redc6t/Agile/README.md

**Agile - Predictive Lap Timer with micro-sector analysis**

GPS lap timer and driver display for circuit racing. Agile times laps and micro-sectors, records the track outline and the pit lane, fuel bay and pit exit geofences, and shows pit board messages and race-control flags sent from the pit wall on the driver's dash.

Part of the Mullaloo Motorsport Engineering in-car system, alongside [BTTM](https://github.com/redc6t/BTTM) (Brake & Tyre Temperature Monitor) and [CIRTS](https://github.com/redc6t/CIRTS) (CAN Infrared Temperature Sensor). Consumed by [PWSM](https://github.com/redc6t/PWSM_Pit_Wall_Stategy_Manager) (Pit Wall Strategy Manager).

| | |
|---|---|
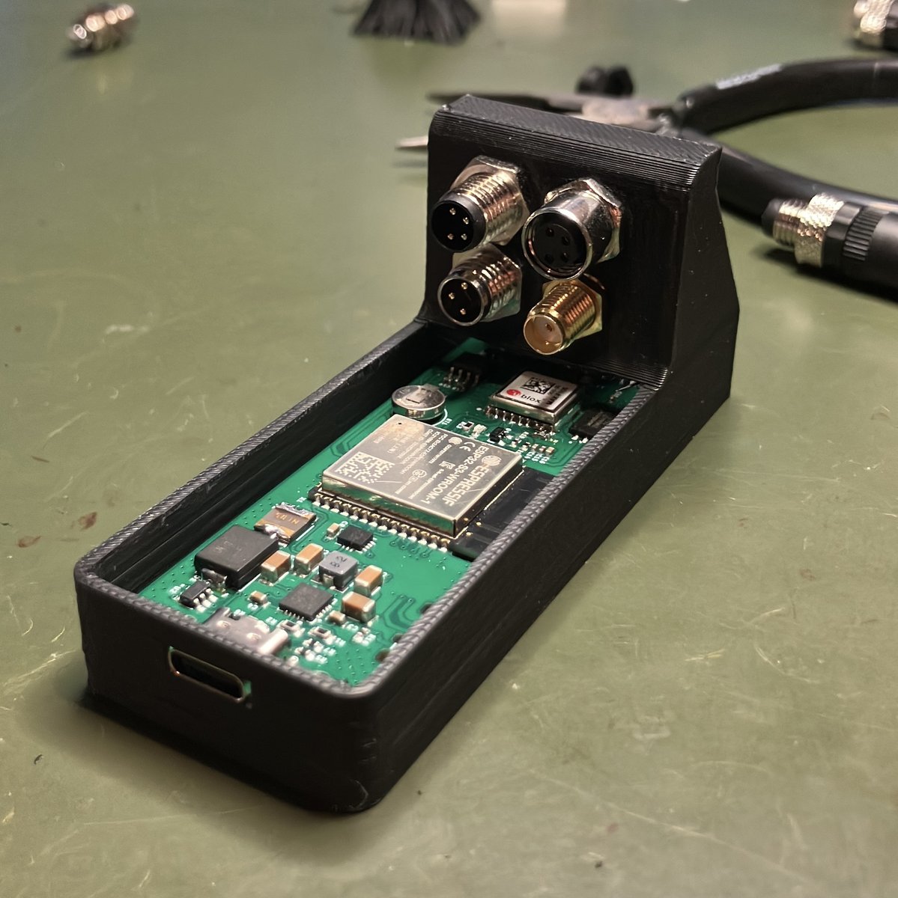
[picture p1: Documentation/Photos/agile_v1.0_open_mainboard.jpg]
Inside the v1.0 enclosure: main board with ESP32-S3 and GNSS behind the connector panel
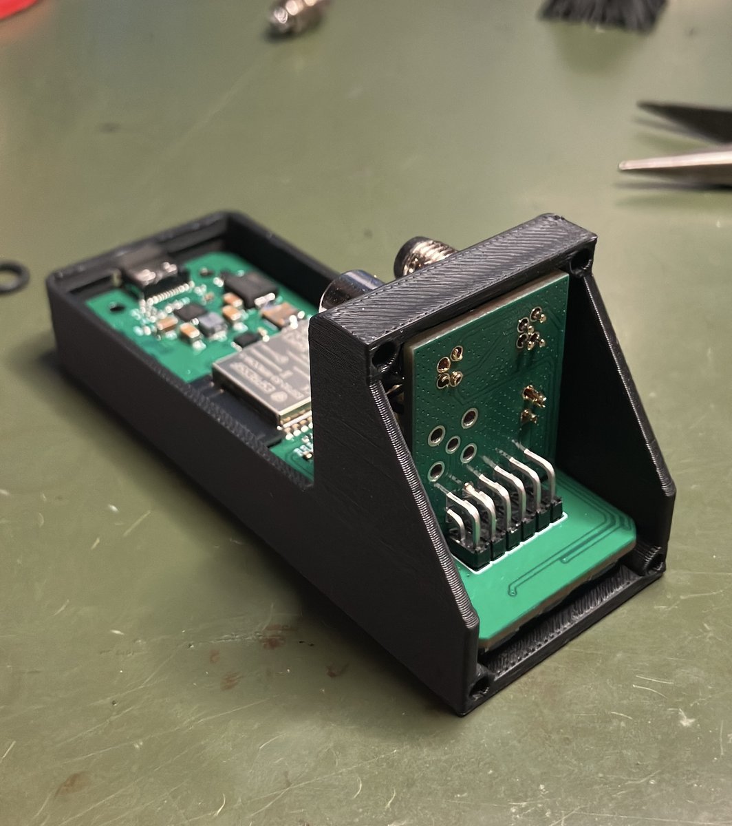
[picture p2: Documentation/Photos/agile_v1.0_open_display.jpg]
Display board in its angled mount inside the open v1.0 enclosure
|  |  |
| Inside v1.0: the main board with the ESP32-S3 and u-blox GNSS behind the connector panel. | The display board in its angled mount, from inside the open v1.0 enclosure. |

Racing dash: gaining 0.8 s

**Features**

- GNSS lap trigger on a start/finish **line** laid across track and pit lane, crossing time interpolated to the millisecond
- Recon lap that builds micro-sectors automatically (up to 32, about one per 150 m)
- Live time delta against the best clean lap, with an auto-ranging delta bar (0.5 to 30 s)
- Geofences for pit entry, pits, fuel bay and pit exit; pit-aware timing (pitted laps never become the reference)
- Pit board messages and latched race-control flags (yellow, safety car, red) the driver cannot dismiss
- IMU (LSM6DSV16X) for sector detection, levelling and GPS-assisted yaw learning
- Append-only NAND session logs, downloadable over Wi-Fi or mounted as a USB drive
- Wi-Fi web app (live view, circuit editor, diagnostics, OTA) plus WebSocket/HTTP API for pit wall clients

**System overview**

```mermaid
flowchart LR
    subgraph Car
        GNSS[MAX-F10S GNSS<br/>10 Hz] --> Agile
        IMU[LSM6DSV16X IMU<br/>240 Hz] --> Agile
        BTN[OK / UP / DOWN] --> Agile
        Agile[ESP32-S3<br/>Agile firmware] --> TFT[284×76 TFT<br/>driver display]
        Agile --> NAND[(512 MB NAND<br/>session logs)]
    end
    Agile <-->|Wi-Fi: HTTP + WebSocket| AP((Trackside AP))
    AP <--> WEB[Browser web UI]
    AP <--> PWSM[PWSM pit wall]
    Agile -.->|USB export mode| PC[PC: LOG_nnnn.CSV]
```

**How a session runs**

```mermaid
stateDiagram-v2
    direction LR
    [*] --> IDLE: boot
    IDLE --> RECON: cross S/F, no stored map
    IDLE --> RACING: cross S/F with stored map accepted (OK)
    RECON --> RACING: cross S/F, sectors synthesised, approve 15 s
    RECON --> IDLE: stopped > 10 s (abort)
    RACING --> RACING: cross S/F, lap closed, faster clean lap becomes reference
    RACING --> IDLE: long OK press (new S/F) or learned-state reset
```

1. Load a circuit (S/F line plus pit zones) from the web Config tab with **Load to Device**. The idle screen shows the circuit name and `S/F:LINE`.
2. Drive across the line. The first lap is a **recon lap**: the unit records the track and finds braking, cornering and acceleration events.
3. At the line it synthesises the micro-sectors and shows `ROAD 9 SEC  OK=KEEP HOLD=REDO`. Lap 2 is timed against the recon lap.
4. Every faster lap that did not touch the pits becomes the new reference. Pit visits are shown full-screen and are left out of the timing.
5. Next time, parked within 500 m of the same S/F, the unit offers `MAP n SEC: OK=USE`, which skips the recon lap.

| Idle, waiting for the line | Recon approve | Latched yellow flag | Pit lane |
|---|---|---|---|
|  |  |  |  |

Every screen and scenario is in [Documentation/Display.md](Documentation/Display.md).

**Driver controls**

| Input | Action |
|---|---|
| OK short | Keep the new sector map / use the stored map / cancel a pending reset |
| OK hold 1.2 to 10 s | Set a point S/F at the current position and start over |
| OK hold 10 s or more | Level the IMU (car still, level ground) |
| UP hold 10 s, stopped | Erase learned state (map, best lap, traces) after a 5 s countdown |
| UP held at power-on | USB log export mode |
| DOWN held at power-on | Five diagnostic pages |
| DOWN held on the approve screen | Synthesis breakdown |

**Web interface**

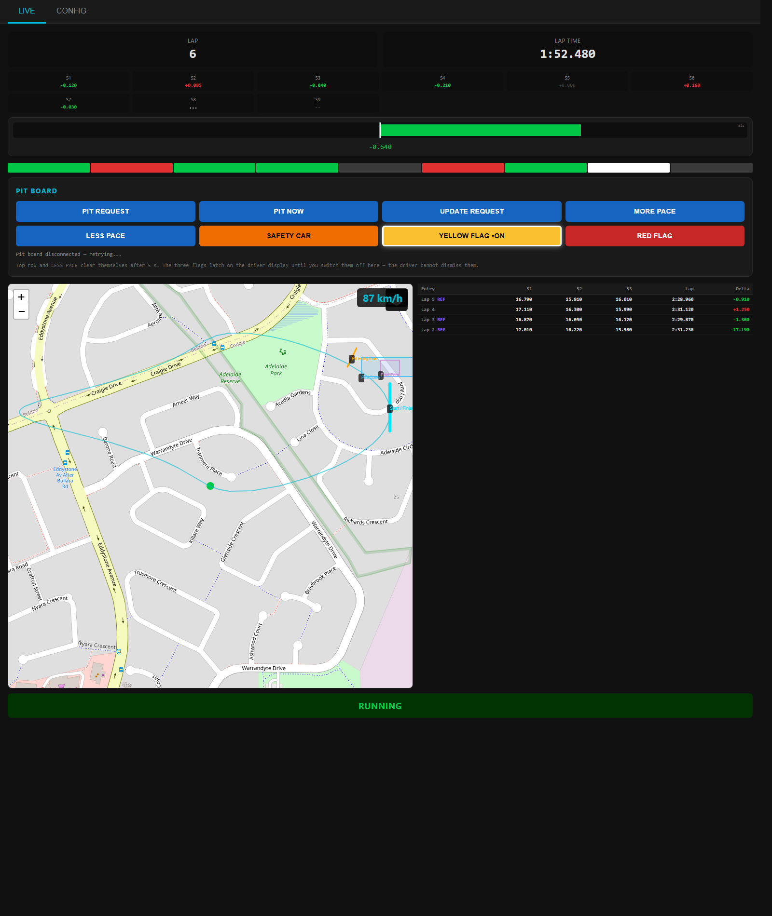
[picture p3: Documentation/WebUI/img/live_tab.png]
Web UI, Live tab


Live tab: lap, sectors, delta bar, pit board, map, lap history. Config tab: circuit and zone editor, Wi-Fi, diagnostics, thresholds, logs, IMU orientation, OTA. See [Documentation/WebUI.md](Documentation/WebUI.md) and the API in [Documentation/Interface.md](Documentation/Interface.md).

**Firmware architecture**

```mermaid
flowchart TB
    subgraph Core0[Core 0]
        G[gnssTask 50 Hz poll] -->|latest fix| L
        I[imuTask 200 Hz] -->|latest sample| L
        L[lapTask 100 Hz<br/>state machine, delta, sectors, geofence]
        L -->|CSV rows| W[logWriterTask] --> N[(NAND)]
        WF[wifiMonitorTask] --> WS[AsyncWebServer + /ws]
    end
    subgraph Core1[Core 1]
        D[displayTask 20 Hz<br/>owner stack + TFT]
    end
    L -->|snapshot, spinlock| D
    L -->|snapshot| WS
    D -->|live frame 10 Hz| WS
    WS -->|pit messages / flags| D
    WS -->|circuits, thresholds, reset| L
```

Full pseudocode of the firmware: [Documentation/Pseudocode.md](Documentation/Pseudocode.md). Architecture notes: [Documentation/Architecture.md](Documentation/Architecture.md).

**Hardware**

<p align="center">
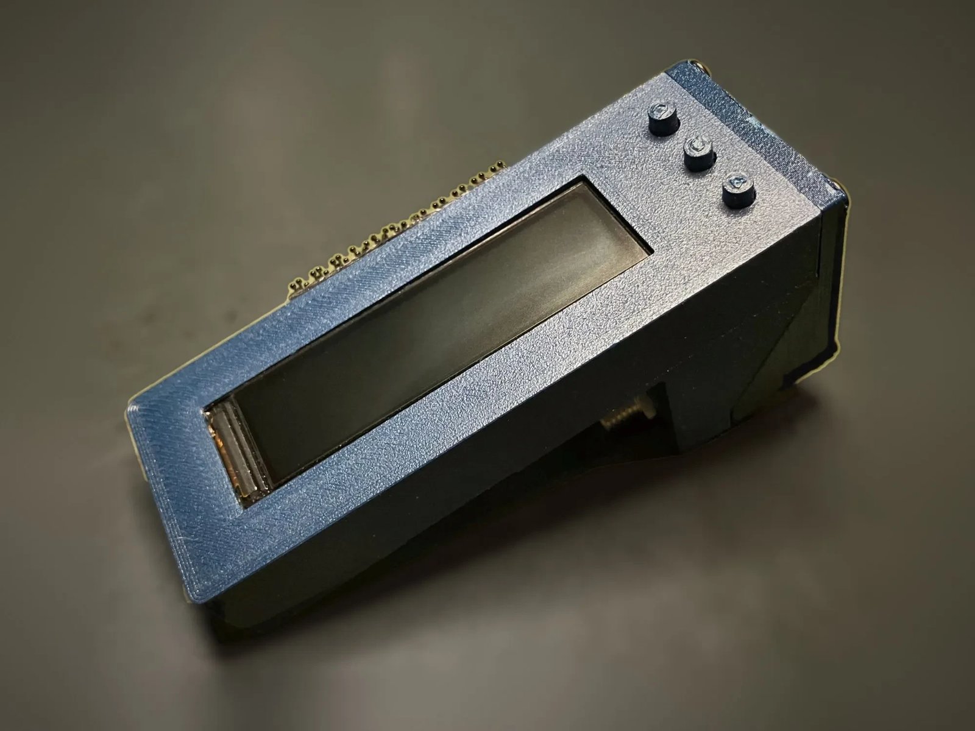
[picture p4: Documentation/Photos/agile_v1.0.jpg]
Agile v1.0: angled 3D-printed enclosure with the 284×76 TFT and OK / UP / DOWN buttons
  
</p>

| Component | Part | Interface |
|---|---|---|
| MCU | ESP32-S3-WROOM-1-N16R8 (16 MB flash, 8 MB OPI PSRAM) | - |
| GNSS | u-blox MAX-F10S (GPS L1, Galileo E1/E5a, BeiDou B1C/B2a) | UART1, 460800 baud |
| IMU | ST LSM6DSV16X | SPI (FSPI) |
| Storage | Winbond W25N04KV 4 Gbit SPI NAND | SPI (HSPI, shared with TFT) |
| Display | ST7789 TFT, 284×76 | SPI (HSPI) |
| CAN | TI TCAN3413 (fitted, disabled in firmware) | TWAI |
| Buttons | OK, UP, DOWN | GPIO 8 / 11 / 12 |

Parts as used by firmware v0.17.0. All PCB designs are custom. See [Hardware](Hardware/README.md).

**Repository layout**

```text
Agile/
├── README.md                 this file
├── Documentation/
│   ├── Architecture.md       block diagram, tasks, timing logic, storage
│   ├── Pseudocode.md         the whole firmware as pseudocode
│   ├── Display.md            every TFT screen and scenario (rendered)
│   ├── Display/
│   │   ├── render_tft.py     regenerates the screens from the firmware's drawing code
│   │   └── screens/*.svg     63 rendered screens
│   ├── WebUI.md              web app, tab by tab
│   ├── WebUI/
│   │   ├── mock_server.py    serves the real web UI against mock data
│   │   └── img/              screenshots
│   ├── Interface.md          WebSocket + HTTP API (PWSM)
│   ├── Flowchart/            state machine diagrams
│   └── Manuals/              driver / pit crew / installation manuals
├── Firmware/
│   ├── Agile/                Arduino sketch (Agile.ino)
│   ├── lib/                  local libraries
│   ├── tools/                partitions.csv, host helpers
│   ├── releases/             tagged binaries
│   └── CHANGELOG.md
├── Hardware/
│   ├── PCB/                  LibrePCB project, schematic and board PDFs, 3D STEP
│   ├── Fabrication/          Gerber, BOM, CPL per revision
│   ├── Enclosure/            Onshape exports
│   └── Datasheets/
└── Photos-Journal_Megadump/  build journal photos
```

| Path | Contents |
|---|---|
| [Firmware/](Firmware/README.md) | Arduino sketch, local libraries, tools, release binaries, firmware changelog |
| [Hardware/](Hardware/README.md) | LibrePCB project, fabrication outputs (Gerber/BOM/CPL), enclosure CAD, datasheets, PCB changelog |
| [Documentation/](Documentation/README.md) | Architecture, pseudocode, display, web UI, pit wall interface, manuals, flowcharts |
| Photos-Journal_Megadump/ | Build journal photos, one folder per milestone |

**Applications**

Designed for circuit racing, track days and motorsport testing, giving entry-level drivers and club teams timing and pit wall communication usually reserved for well-funded teams.

**License**

| Part | Licence |
|---|---|
| Hardware (schematics, PCB, fabrication files, enclosure) | [CERN-OHL-S-2.0](https://ohwr.org/cern_ohl_s_v2.txt) |
| Documentation (including the firmware pseudocode and diagrams) | [CC BY 4.0](https://creativecommons.org/licenses/by/4.0/) |
| Firmware (source and binaries) | Proprietary, all rights reserved. The source is not published; binaries are free to use on Agile hardware. See [Firmware/LICENSE](Firmware/LICENSE). |

See [LICENSE](LICENSE) for details.

By: Pietro Gambarin (pietro.gambarin@gmail.com)
