redc6t/Agile/Hardware/PCB/3D/PLTD_v1.1.step

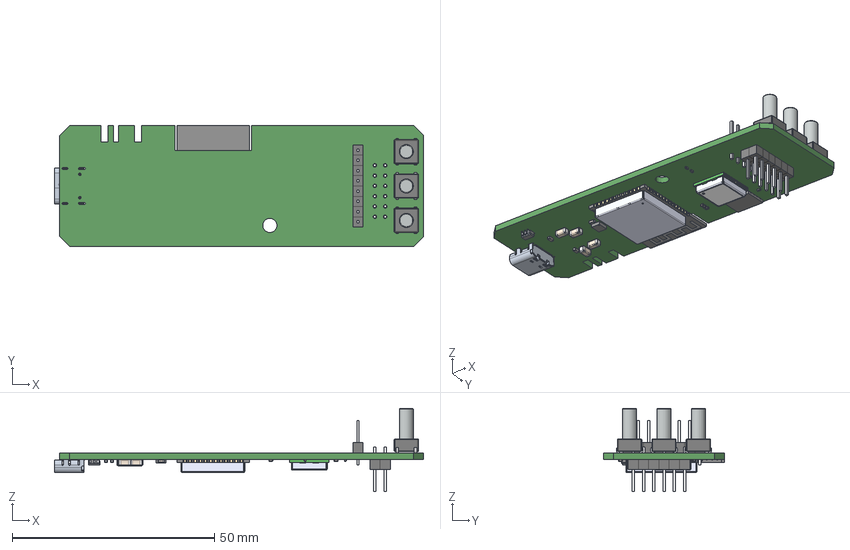
[picture p6: CAD file, 2026-10-16]
Hardware/PCB/3D/PLTD_v1.1.step
91.2 x 30.0 x 20.6 mm
PCB:1
C1:1
C2:1
C3:1
C4:1
C5:1
C6:1
C8:1
C10:1
C14:1
C15:1
C16:1
C17:1
C18:1
C19:1
DOWN:1
INTERFACE_IN:1
J2:1
J4:1
RESET-OK:1
U2:1
U3:1
U5:1
U6:1
UP:1
X1:1
