redc6t/Agile/Hardware/pcb_changelog.txt

Agile - Predictive Lap Timer with micro-sector analysis

v0.1 (Work in progress)
- Initial board
