redc6t/Agile/Photos-Journal_Megadump/1) 0.17 photoshoot/IMG_3626.jpeg

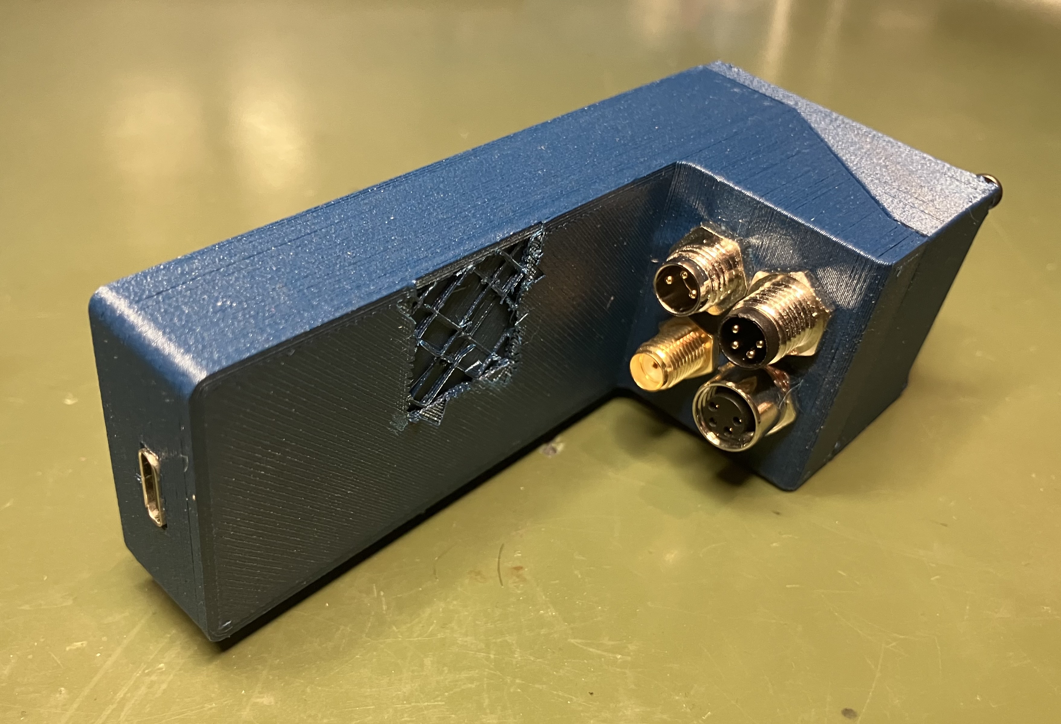
Photos-Journal_Megadump/1) 0.17 photoshoot/IMG_3626.jpeg
