redc6t/Agile/Hardware/PCB/Schematic/PLTD_v1.1_Schematics.pdf

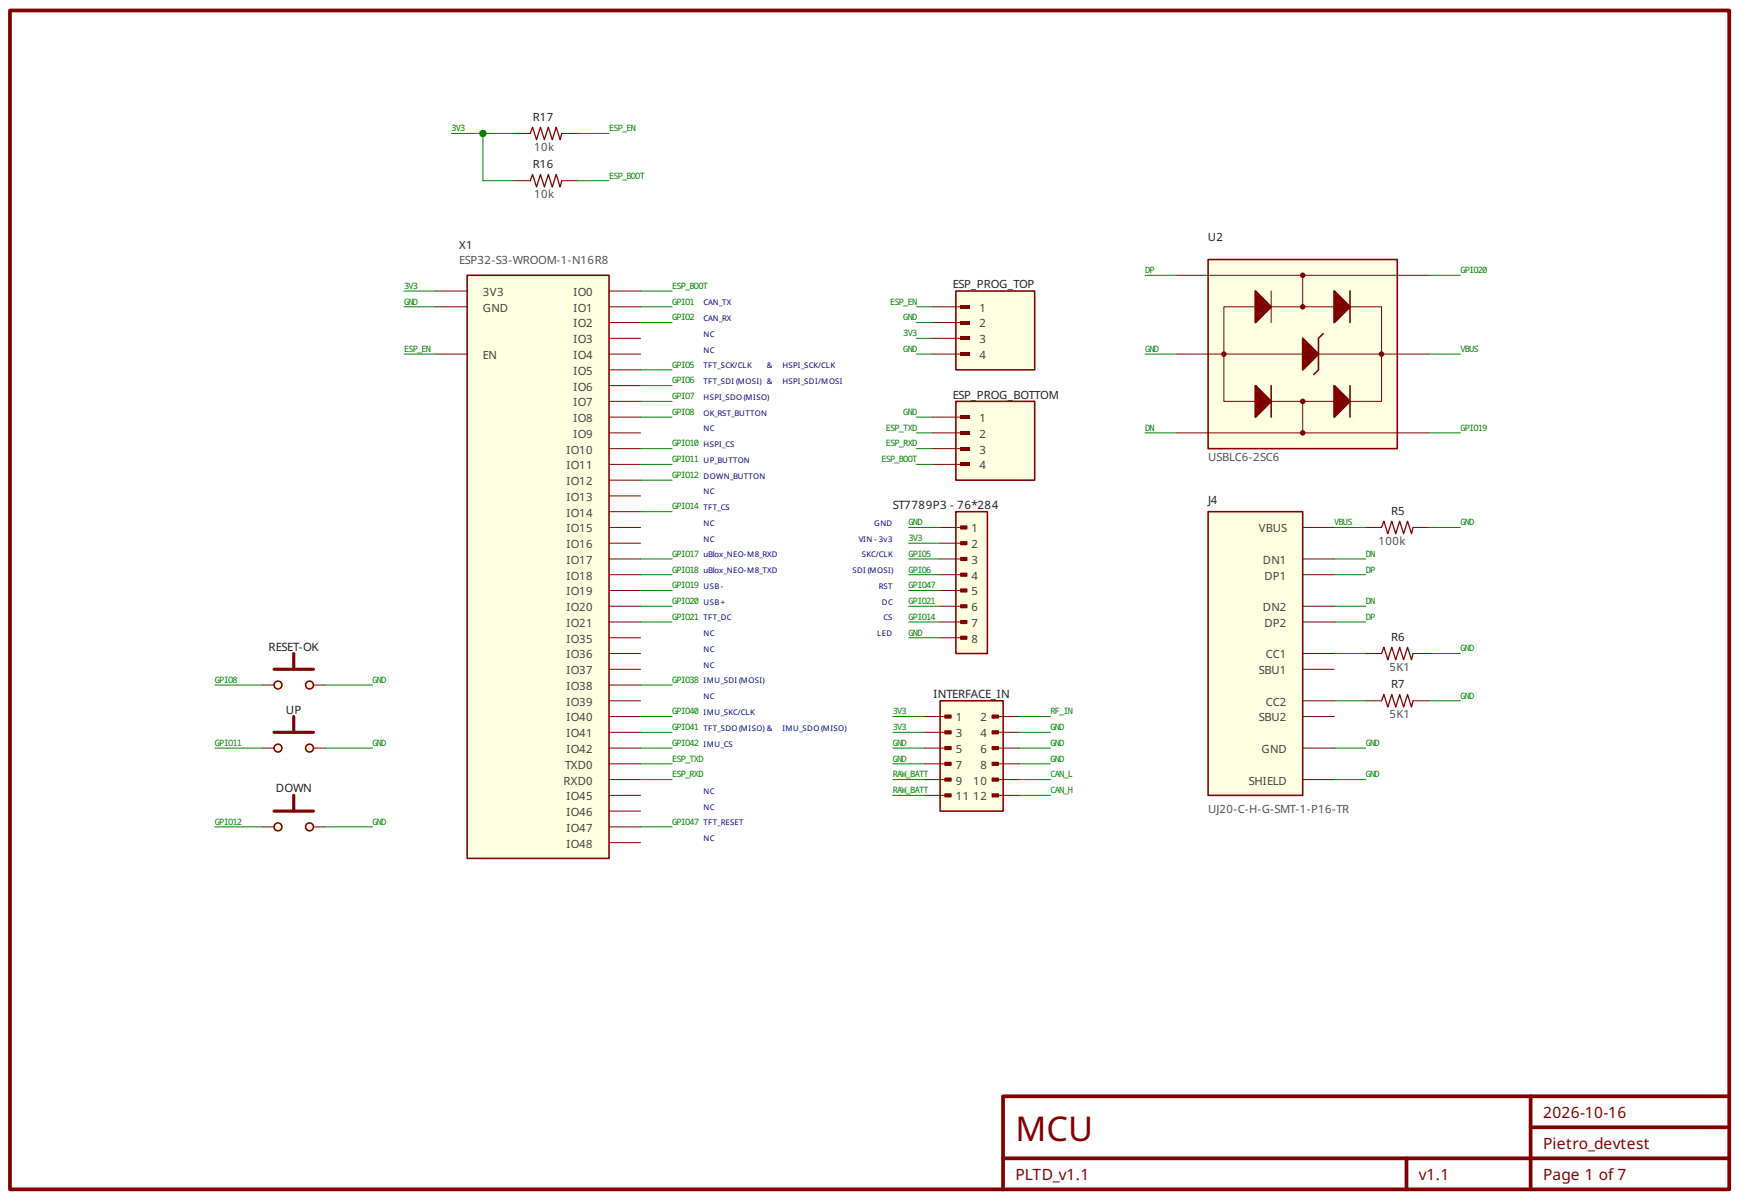
[picture p12: page 1]
IMU_SDO (MISO); SDI (MOSI); VIN - 3v3; TFT_SDI (MOSI); IMU_SDI (MOSI); TFT_SDO (MISO); HSPI_SDO (MISO)

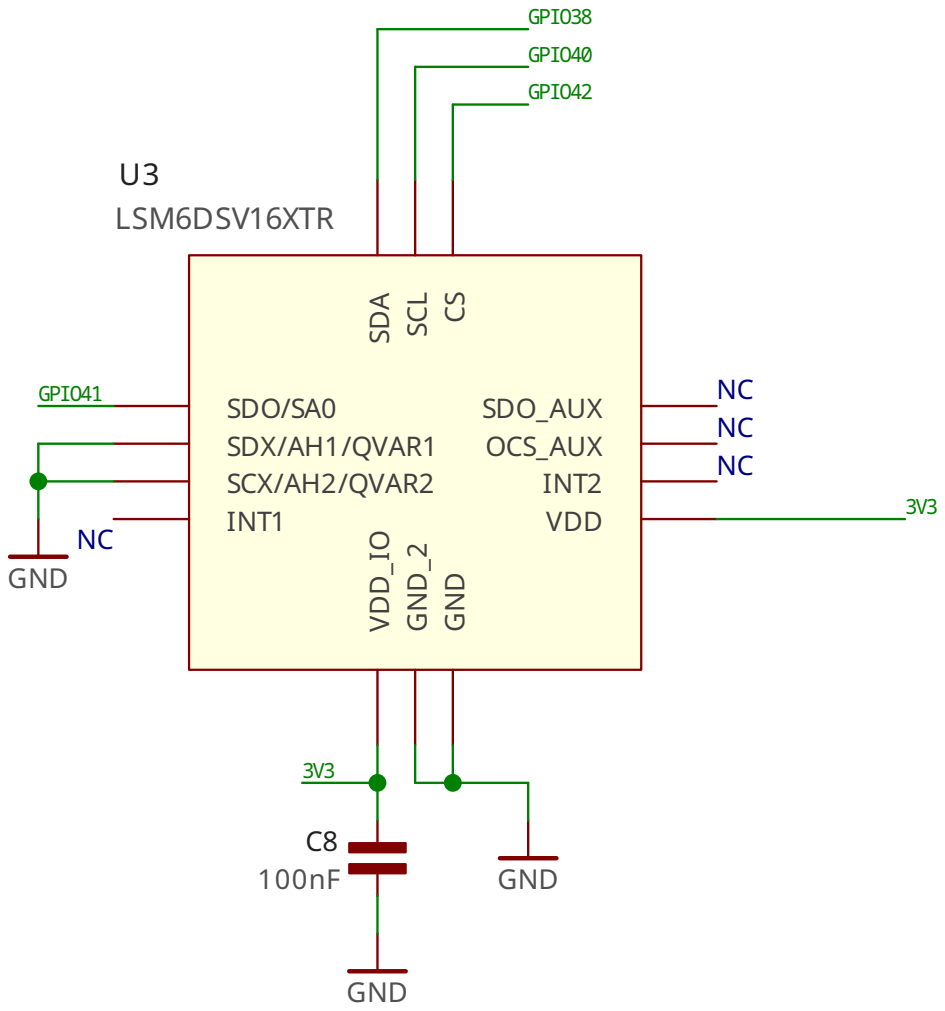
[picture p13: page 2]
Pietro_devtest IMU

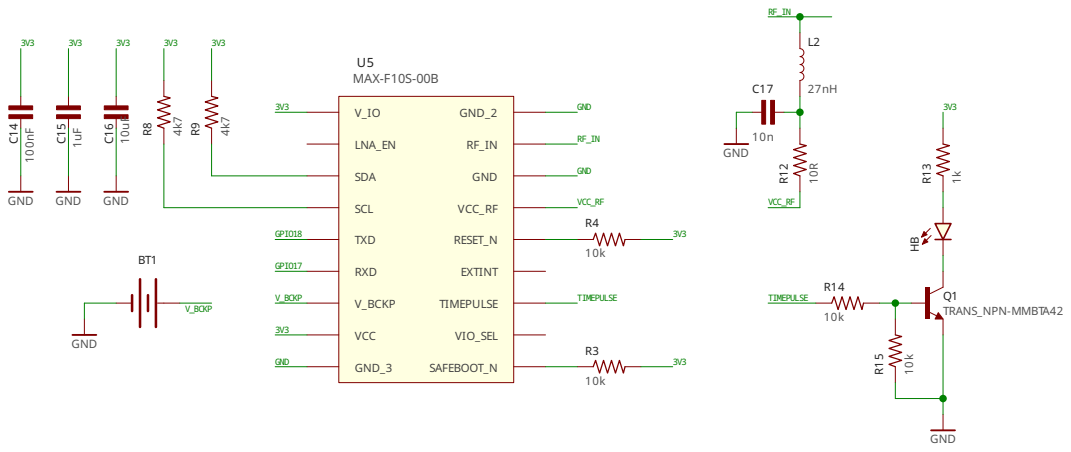
[picture p14: page 3]

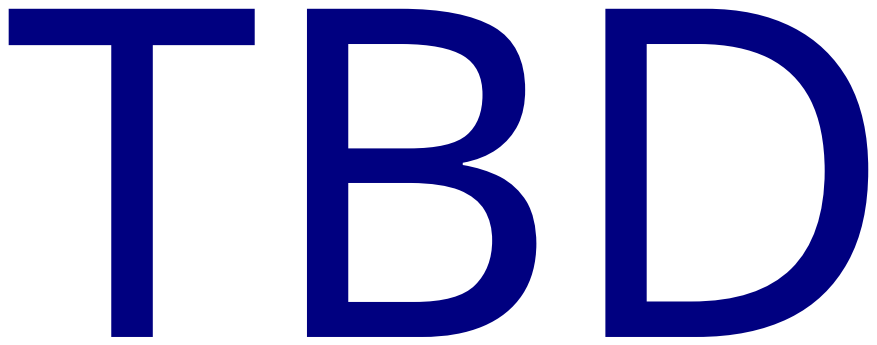
[picture p15: page 4]

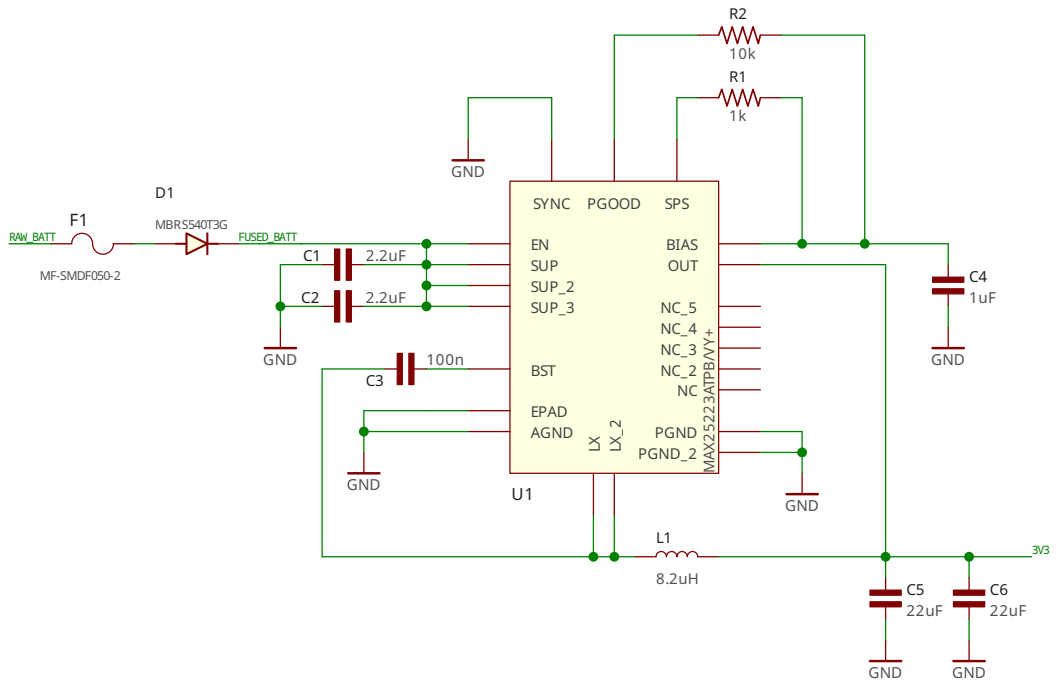
[picture p16: page 5]

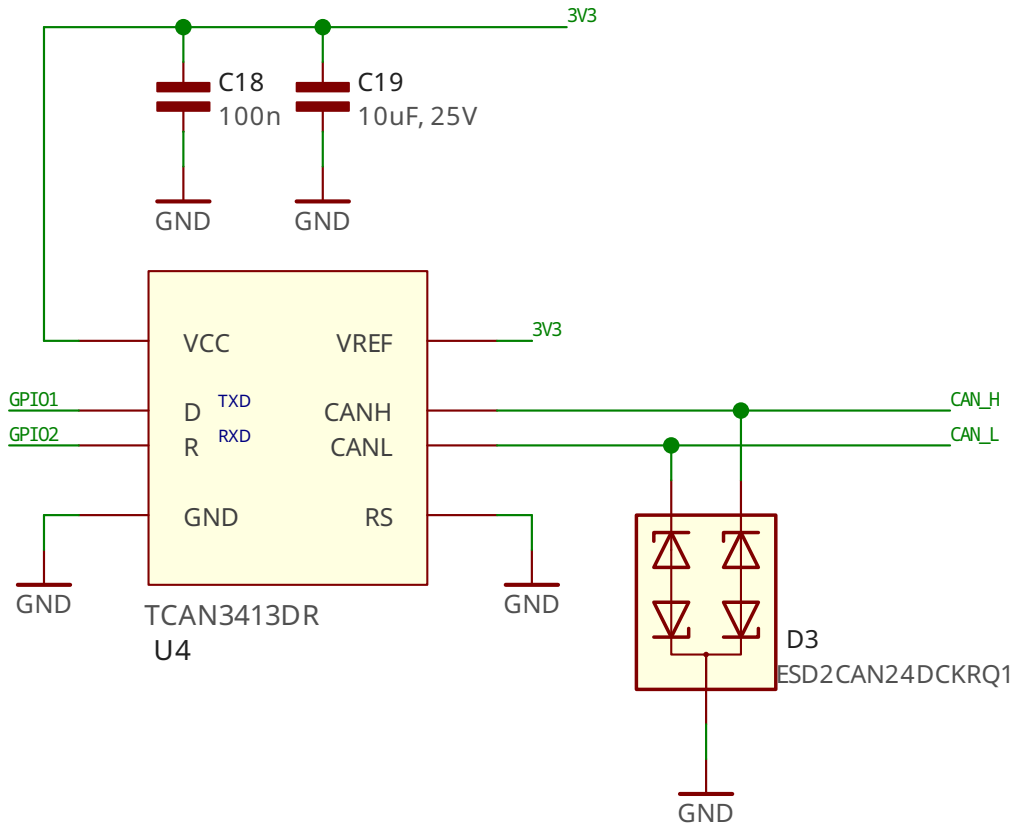
[picture p17: page 6]

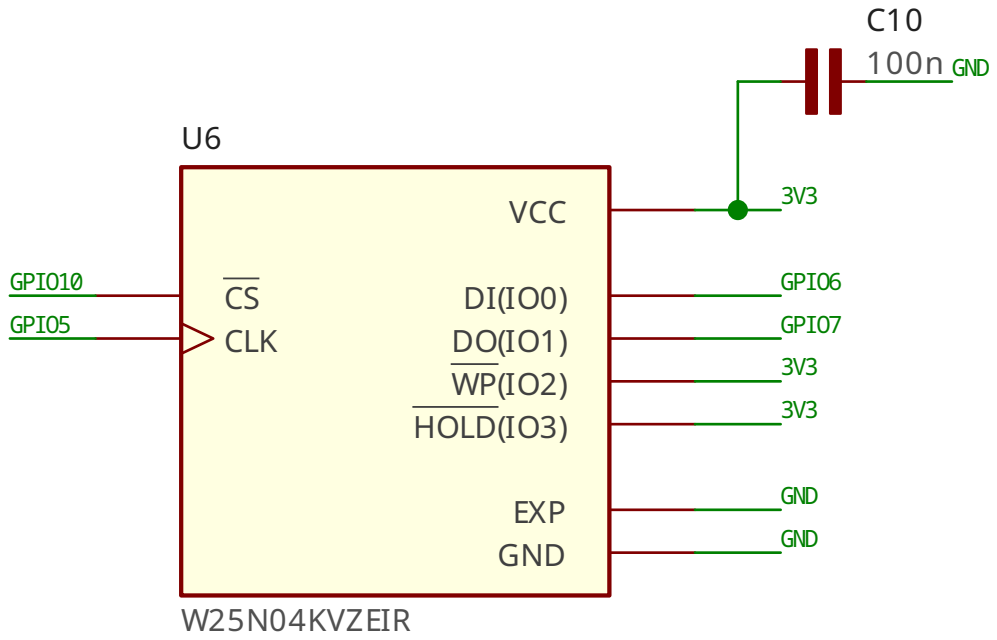
[picture p18: page 7]
Memo; Pietro_devtest ry
