redc6t/Agile/Hardware/PCB/Board/PLTD_v1.1_Board.pdf

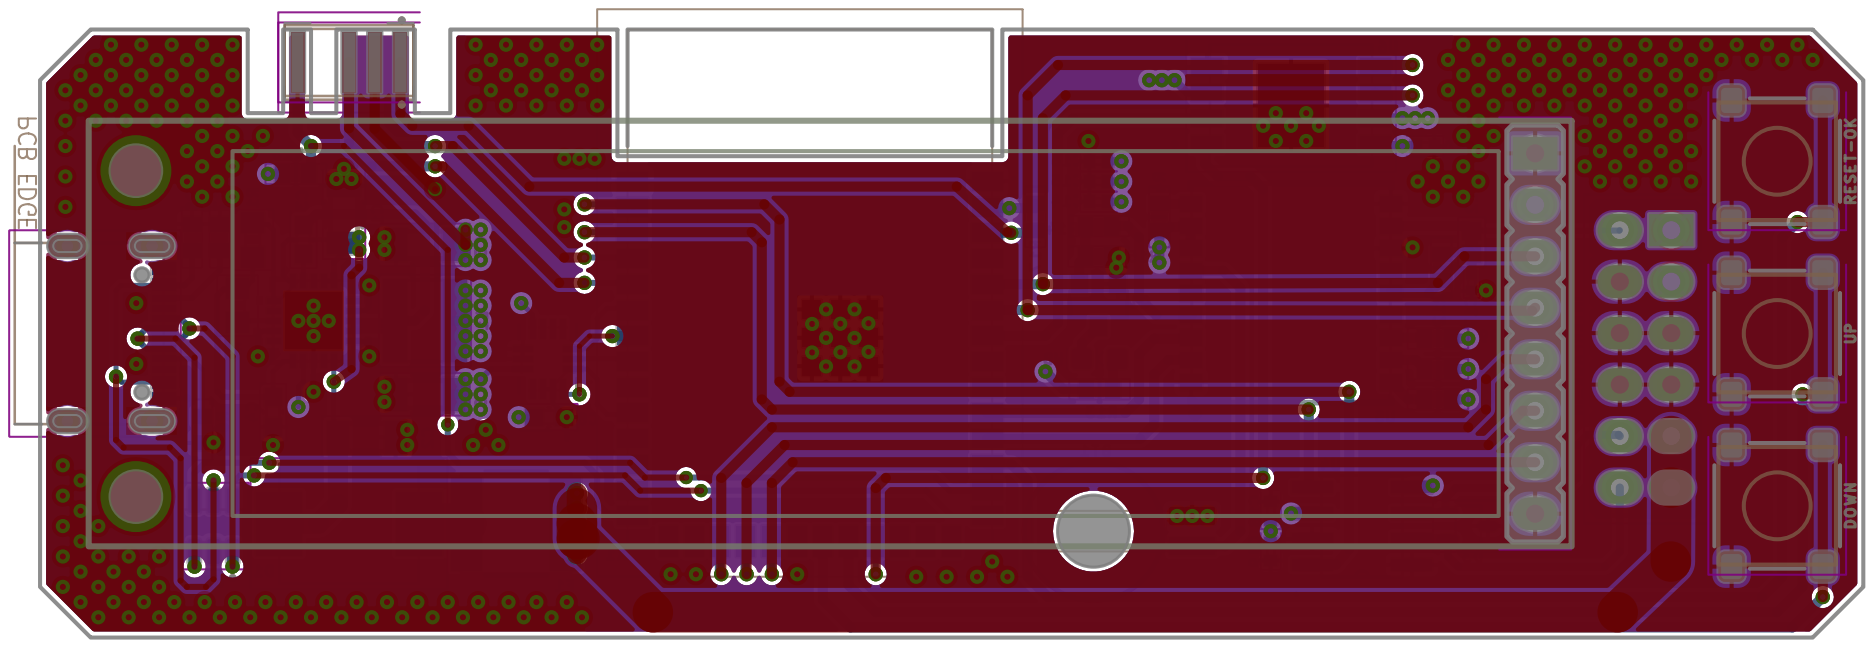
[picture p19: page 1]

UP DOWN RESET-OK

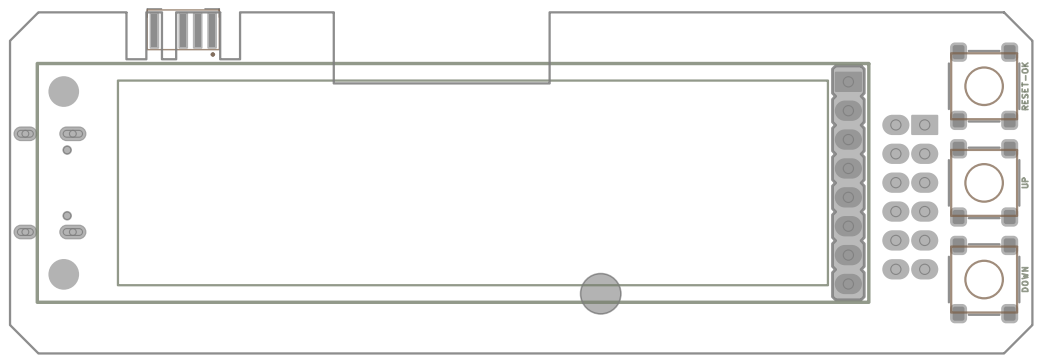
[picture p20: page 2]

UP DOWN RESET-OK

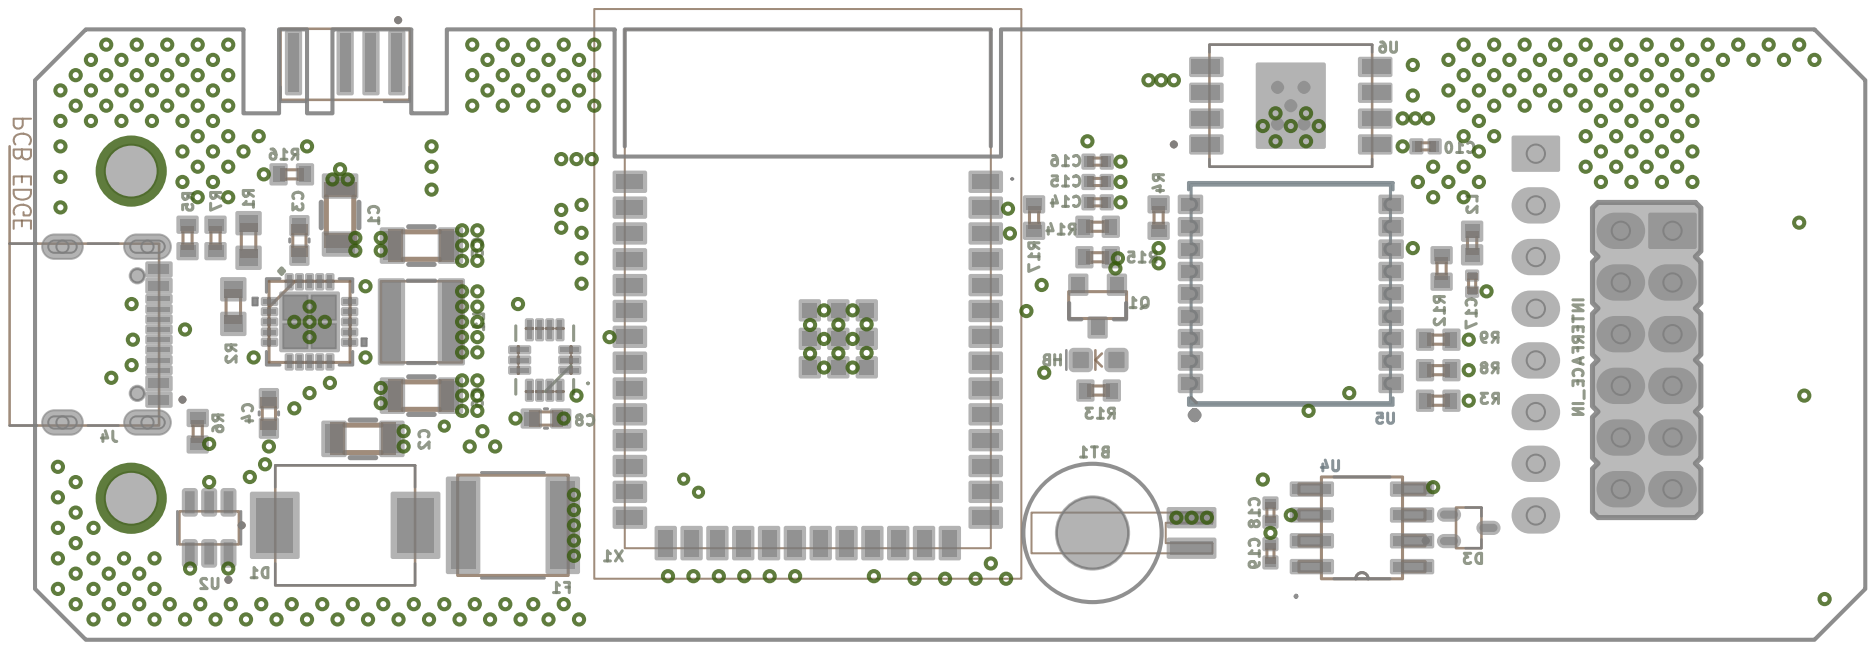
[picture p21: page 3]

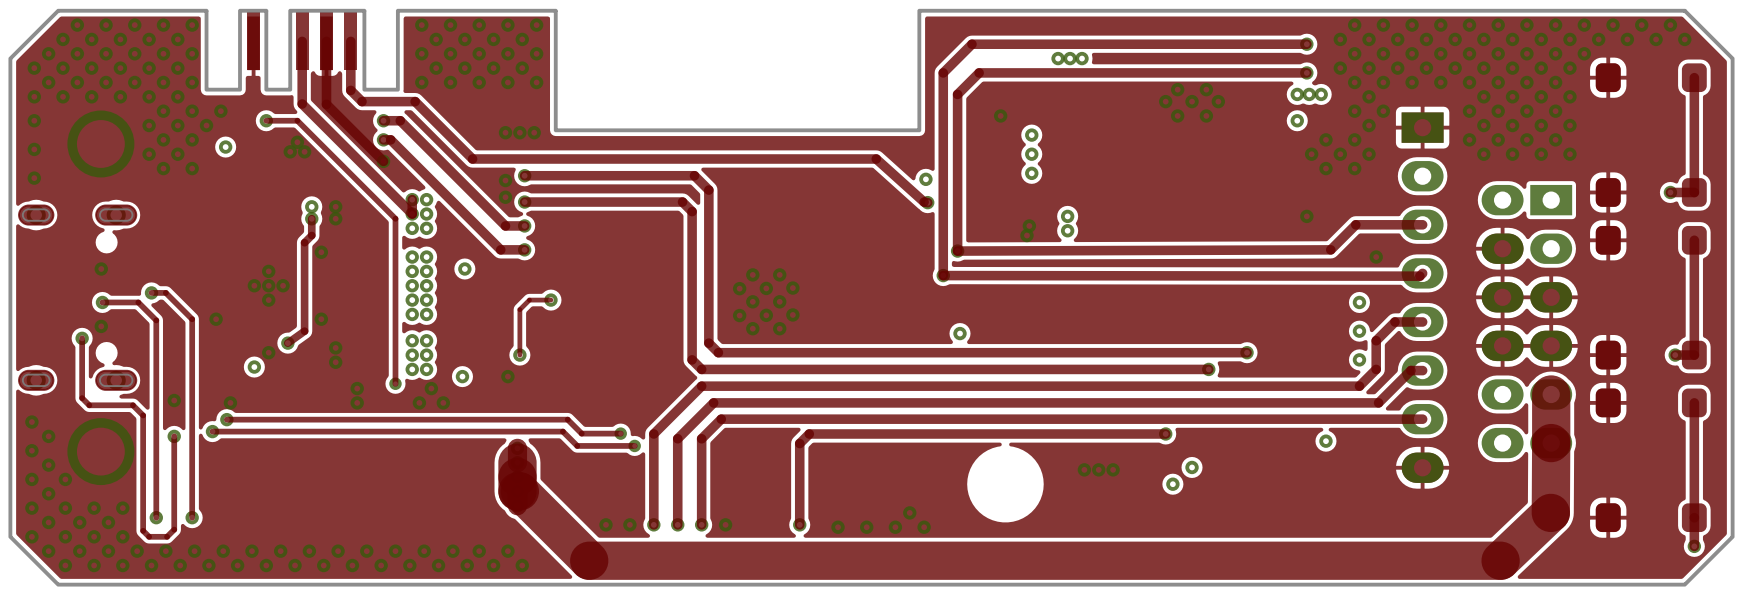
[picture p22: page 4]

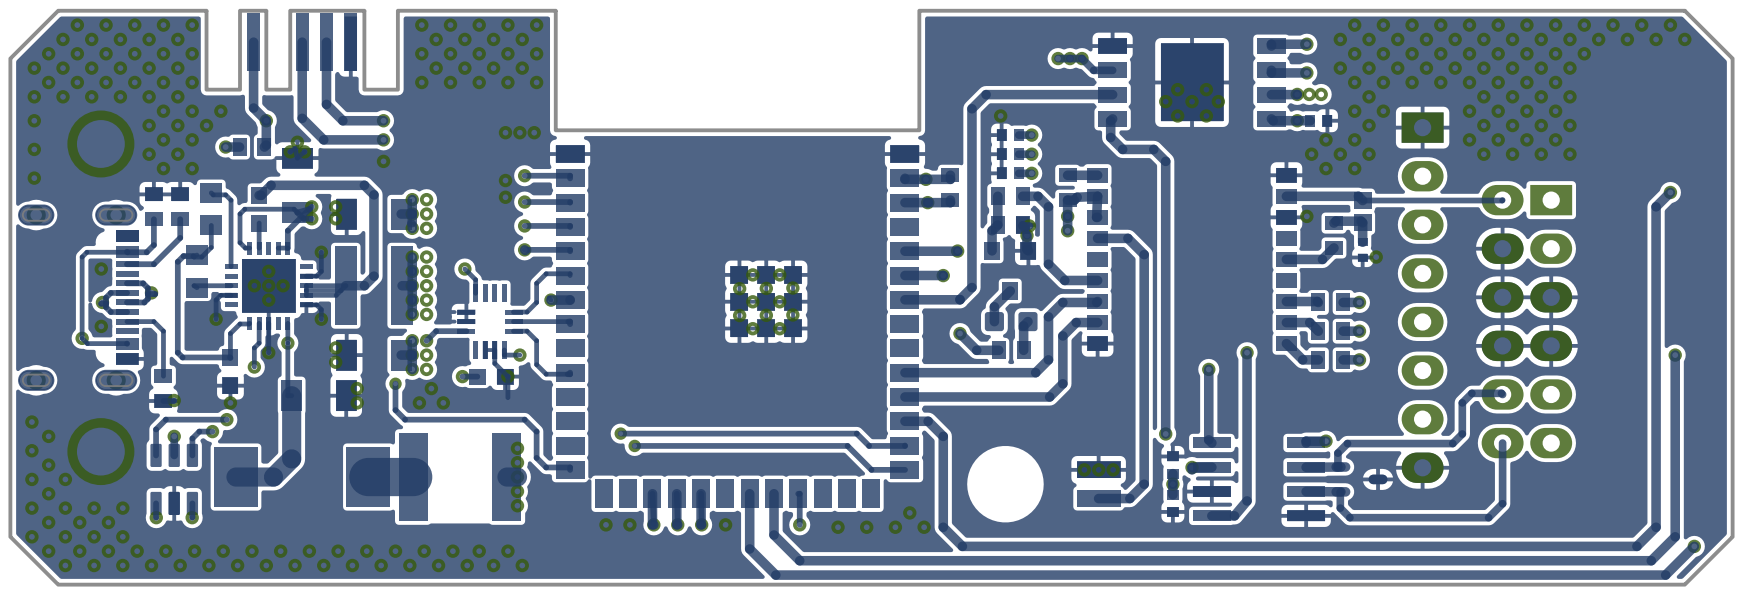
[picture p23: page 5]
