redc6t/Agile/(commit log)

2026-10-16 Replace MIT with split licensing: open hardware and docs, proprietary firmware
    - LICENSE: replace the MIT text with a per-part notice. Hardware is
    CERN-OHL-S-2.0, documentation (including the pseudocode) is CC BY 4.0,
    and firmware is proprietary.
    - Firmware/LICENSE (new): all rights reserved. Binaries may be used on
    PLTD hardware only; no modification, redistribution or reuse in other
    products. Third-party library licences keep their own rights. No
    warranty, not a safety device, and the licence terminates on breach.
    - README.md: licence section rewritten as a per-part table; drops the
    old MIT/GPL lines.
    - Hardware/README.md: hardware licence changed from CC BY-SA 3.0 to
    CERN-OH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
2026-10-16 Add hardware technical specification for PCB v1.1 / firmware v0.17.0
    New Documentation/TechnicalSpec.md compiled from the v1.1 schematic,
    board prints and STEP model, plus the v0.17.0 firmware docs.
    - Board outline, power path and rails, MCU/flash/PSRAM, partition table
    - Full GPIO map with firmware usage
    - GNSS, IMU, NAND, TFT, USB-C, CAN, buttons, HB LED sections
    - INTERFACE_IN pinout, programming headers, task/bus resource map
    - BOM from schematic
    - Known discrepancies and open items (stale labels, no USB power,
    no EN cap, no CAN termination, uncharacterised power figures)
    Linked from Documentation/README.md.
2026-10-17 Rename product from PLTD to Agile in docs and licences
    Replace PLTD with Agile across README, LICENSE, firmware licence,
    changelogs, hardware naming convention and all documentation.
    Move the sketch folder Firmware/PLTD/ to Firmware/Agile/ and update
    .gitignore. Add a former-name clause to the firmware licence so
    already-shipped PLTD units stay covered.
    Firmware identifiers that v0.17.0 still uses (USB "PLTD LOG STORE",
    NVS "pltd-wifi") and released file names (PLTD_v1.1 PDFs/STEP,
    PLTD_v0.17.0.ino.bin) are left as-is until the next firmware and
    board export.
2026-10-17 Rename product from PLTD to Agile in docs and licences
    New name and tagline: "Agile - Predictive Lap Timer with micro-sector
    analysis" (README, LICENSE, PCB changelog). Replace PLTD with Agile
    across the firmware licence, changelogs, hardware naming convention
    and all documentation. Move the sketch folder Firmware/PLTD/ to
    Firmware/Agile/ and update .gitignore. Add a former-name clause to
    the firmware licence so already-shipped PLTD units stay covered.
    NVS "pltd-wifi", which stays) and released file names (PLTD_v1.1
    PDFs/STEP, PLTD_v0.17.0.ino.bin) are left as-is until the next
    firmware and board export.
    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
2026-10-22 Document TFT backlight dimming mod and v0.18.0 brightness API
    Firmware v0.18.0 (source kept local in Sauce/) adds TFT backlight
    brightness control from the web Config tab: 10-100 % slider with live
    preview, Day/Dusk/Night presets, NVS-saved level applied before the TFT
    starts.
    Hardware: v1.1 rework switches the TFT LED pin low-side with an
    MGSF1N03LT1G, gate on GPIO48 via 100R with a 10k pull-up to 3V3
    (backlight fails full-on; the pull-up also lets firmware detect the mod).
    - TechnicalSpec: GPIO48 row, new section 7.4.1 with wiring, detection
    and bench check, open item 8 updated
    - Interface: GET/POST /brightness
    - WebUI: Display Brightness card
    - CHANGELOG: v0.18.0 entry (provisional, n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
2026-10-25 Add enclosure photos to README
    Add a hero shot of the v1.0 unit under the intro and two open-enclosure
    photos (main board, display board) at the top of the Hardware section.
    Web-sized copies (≤1600 px, ~150-180 KB each) live in
    Documentation/Photos/ so the README doesn't pull the full-resolution
    originals from Photos-Journal_Megadump/.
2026-10-25 Add enclosure photos to README
    Add two open-enclosure photos (main board, display board) side by side
    under the intro, and a shot of the finished v1.0 unit at the top of the
    Hardware section.
    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
2026-11-05 v0.20.0: fuel zone from any state, sector pass timing, Config panels
    - CHANGELOG: v0.20.0 entry (fuel zone triggers from any car state, sector
    boundaries complete at closest approach instead of a 30 m circle, boot
    log rows flushed again, SEC log row per boundary, Config tab grid layout)
    - Pseudocode: fuel zone resolved after the zone loop, from any state;
    state diagram gains RUNNING -> FUELLING and FUELLING -> RUNNING
    - WebUI: Fuel Zone row and a note on the new Device Settings panel grid
2026-11-05 v0.20.1: finish sector timed at S/F, geo_label cleared
    v0.20.1 entry (finish sector from the last IMU boundary to
    S/F, closed by the S/F crossing, appended to older stored maps;
    geo_label empty outside custom zones; v0.20.0 confirmed on track in
    LOG_0002)
    - Pseudocode: sector completion now describes the closest-approach pass
    (v0.20.0) and the finish sector closed at the lap crossing; synthesis
    step 5b appends the finish sector; diagram updated
2026-11-10 Document v0.21.0 engineer view: recon feed, remote OK, sector map
    Firmware v0.21.0 (source local-only) adds web-side visibility for running
    the car from the pits; recon, synthesis, timing and geofence logic are
    unchanged.
    - CHANGELOG: v0.21.0 entry (driver display mirror, recon card with
    Keep / Use stored map / Discard, live event log, read-only sector map,
    EVT log rows, /recon /events /approve).
    - Interface.md: GET /recon, GET /events, POST /approve.
    - WebUI.md: v0.21.0 engineer view section.
    - mock_server.py: replays a recon lap (IDLE, 40 s recon, approve window),
    serves /recon and /events, handles POST /approve and /nuke.
2026-11-12 v0.21.1: pits zone triggers from RUNNING, entry line optional
    The pits polygon only switched the car to PITS from PIT ENTRY, so the
    pit entry line had to fire first. A circuit without an entry line, or a
    car that booted in the garage, stayed RUNNING inside the pits.
    - Inside any pits polygon from RUNNING or PIT ENTRY is PITS (not from
    PIT EXIT; an exit line crossed on the same fix and the fuel zone
    still win). Entry and exit logged as GEO/INFO rows.
    - Leaving PITS is decided on outside every pits polygon (a second
    polygon no longer forces PIT EXIT).
    - CHANGELOG and Pseudocode car-state section updated.
